100-Ton-Robot/ble-beacon-tracker/rf_model/out/h50327_c65_s15/summary.txt

command: python3 sector_model.py --antenna dipole --centre 65 --spacing 15 --out out/h50327_c65_s15
date: 2026-11-13 03:23 UTC
antenna: dipole, element 58.4 mm, 15 mm in front of the face, feed 65 mm below the deck, other sectors' antennas in, 50 ohm
f0 2440 MHz, mesh [61, 60, 54] cells

match (sector 0 port, 50 ohm):
  2402 MHz  S11   -3.0 dB  Zin   38.2  +87.7j ohm
  2440 MHz  S11   -2.4 dB  Zin   41.7 +104.8j ohm
  2480 MHz  S11   -2.0 dB  Zin   45.9 +123.5j ohm

peak 8.8 dBi at az 0, el 5 deg

elevation   max dBi   at az   -3 dB width   front-to-back (az 0 vs 180)
     0         8.8       0       85 deg       20.5 dB
   -15         7.5       0       85 deg       15.6 dB
   -30         4.1       0      105 deg       17.8 dB
   -45        -1.5       0      145 deg        7.6 dB
   -60        -6.6     290      225 deg       -2.0 dB

isolation, sector 0 -> other sectors' ports (|S21|):
  S1: -50.2 dB
  S2: -50.2 dB
