100-Ton-Robot/ble-beacon-tracker/shield_deck/shield_deck_templates.pdf

## Shield deck drill template - 146 mm disc - PRINT AT 100% (Actual size)

Viewed from the TOP (electronics side). Tape to the board, centre-punch each crosshair, then drill.

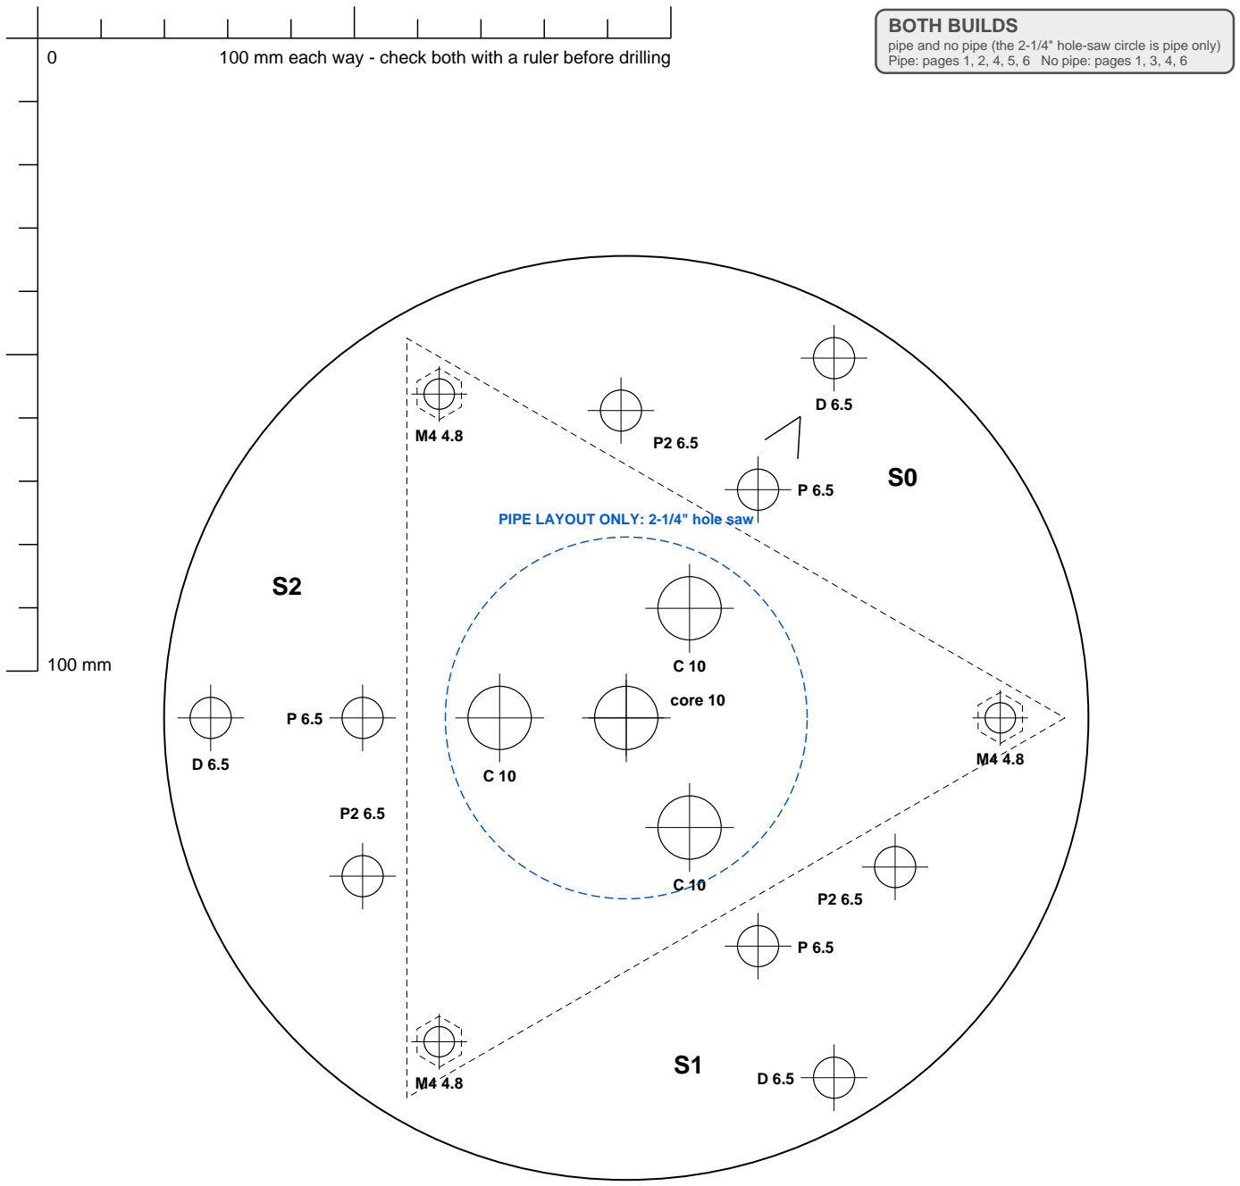
[picture p1: figure]
core 10; PIPE LAYOUT ONLY: 2-1/4" hole saw; BOTH BUILDS

0 | 100 mm each way - check both with a ruler before drilling

Solid circle = cut line (146 mm). Dashed triangle = where the 120 mm back panels stand, copper side out.
D 6.5 mm = rubber duck / monopole / dipole whip (31 mm in front of face) P / P2 6.5 mm = patch (7 mm in front of face; P2 25 mm off centre) C 10 mm = dipole coax pass-through (inside core) M4 4.8 mm = bolts to the plate, nut flush in each core corner
Core 10 mm at the centre = antenna coax into the core; open it up with a hole saw (centre mark) if needed.
Blue dashed 57.1 mm (2-1/4" hole saw) = pipe layout only (page 2): the pipe passes into the core;
it removes the C holes. Other layouts keep the 10 mm core hole. EU: a 57 mm hole saw is the same size.
Arrow points to Sector 0. Holes are symmetric, so the template also works flipped (labels read mirrored). Drawn the same way round as the plates: plate 12 o'clock up, S0 arrow 30 deg clockwise of it.

pipe and no pipe (the 2-1/4" hole-saw circle is pipe only) Pipe: pages 1, 2, 4, 5, 6 No pipe: pages 1, 3, 4, 6

## PIPE electronics plate - 152 mm disc - PRINT AT 100% (Actual size)

Viewed from the TOP. XIAOs, mounts + bus hang UNDER the plate (dashed); PoE splitter + ESP32 inside the core. This layout is only a suggestion. Lay out your own parts and check every hole before drilling.

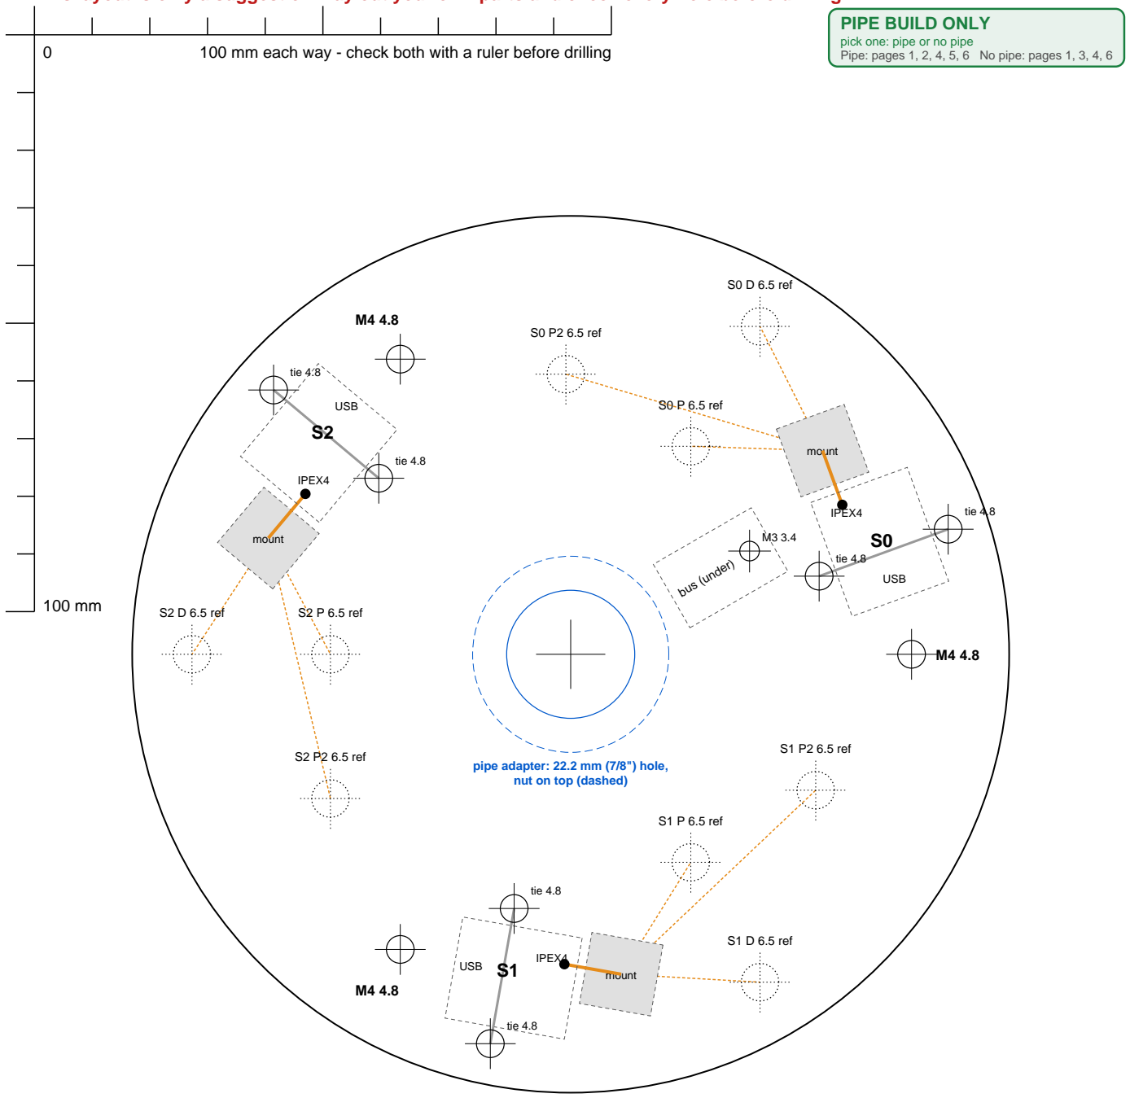
[picture p2: figure]
pipe adapter: 22.2 mm (7/8") hole, nut on top (dashed); mount; USB; IPEX4; bus (under); S0 D 6.5 ref; S0 P 6.5 ref; S0 P2 6.5 ref; S1 D 6.5 ref; S1 P 6.5 ref; S1 P2 6.5 ref; S2 D 6.5 ref; S2 P 6.5 ref; S2 P2 6.5 ref; tie 4.8; PIPE BUILD ONLY pick one: pipe or no pipe

0 | 100 mm each way - check both with a ruler before drilling

Hanging from the ceiling, top down: nut, enclosure top, this module plate, modules + wiring under it, deck, core.
Drill: 3 x 4.8 mm (M4) bolts to the deck, on the deck's M4 holes; 3.4 mm (M3) bus board;
tie hole pairs 4.8 mm (3.0-4.8 fits a 2.5 mm tie), one per XIAO. No pigtail or feed holes: the parts hang under the plate. Antenna holes (dotted, 9 x 6.5 mm): the deck's D / P / P2 jacks, shown for reference only. Not by design; drill if you like. Centre (blue): 22.2 mm (7/8") hole for the 1/2" male adapter's thread, which also goes through the
enclosure top; the nut on top (dashed, size est.) clamps both. Ethernet comes down the pipe (page 5).
EU: a 20 mm x 1/2" BSP male adaptor (R 1/2, 21 mm thread) fits the same 22 mm hole, held by a 1/2" BSP backnut. Each XIAO (under the plate, component side down, beside its own sector): IPEX4 dot -> orange flat coax run ->
1/2" HS-100 tie mount (grey), which clamps it, then (dashed orange) down to whichever of its sector's D / P / P2
jacks is in use, straight below its hole. 5V, GND, D7 to the bus beside them; D6 through the deck's centre hole to
its ESP32 RX pin, beside TX, GND, VBUS coming up. Seen from the top the IPEX4 is on the left (the board is flipped). OPTIONS (builder's choice): this pipe plate or the no-pipe split plate (page 3); bus board under the plate by the adapter, or on the pipe inside the core (page 5: then skip the bus M3).

Pipe: pages 1, 2, 4, 5, 6 No pipe: pages 1, 3, 4, 6

## NO-PIPE electronics plate (split) - 152 mm disc - PRINT AT 100% (Actual size)

Viewed from the TOP. Radios, tie mounts, ESP32 + bus all hang UNDER the plate (dashed, seen through it).
This layout is only a suggestion. Lay out your own parts and check every hole before drilling.

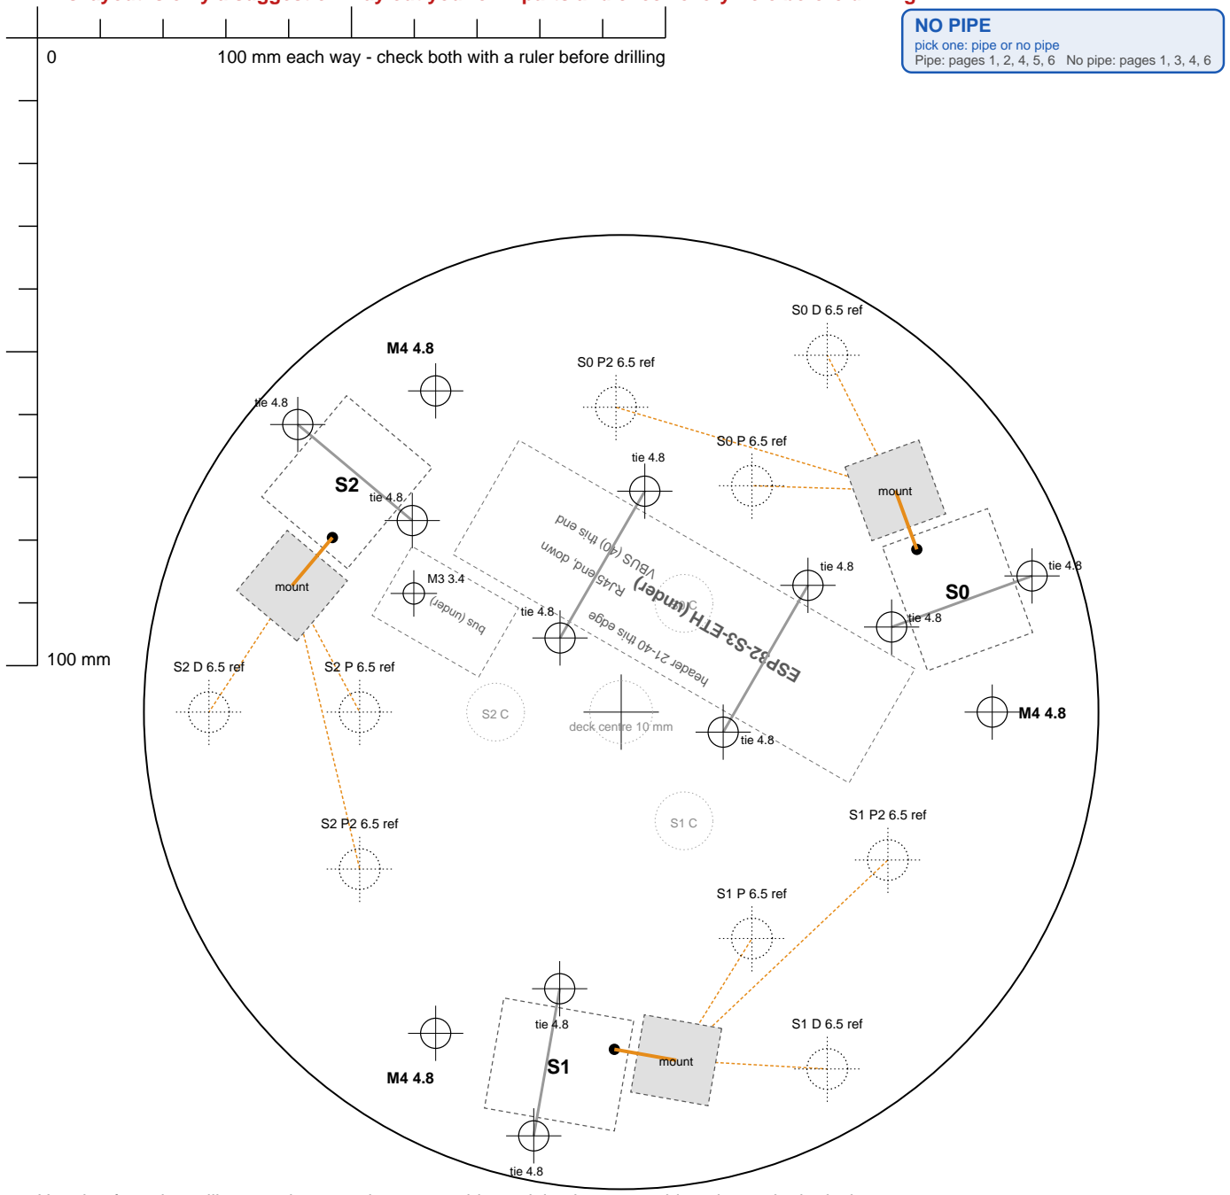
[picture p3: figure]
deck centre 10 mm; mount; S0 D 6.5 ref; S0 P 6.5 ref; S0 P2 6.5 ref; S1 D 6.5 ref; S1 P 6.5 ref; S1 P2 6.5 ref; S2 D 6.5 ref; S2 P 6.5 ref; S2 P2 6.5 ref; tie 4.8; NO PIPE pick one: pipe or no pipe

0 | 100 mm each way - check both with a ruler before drilling

Hanging from the ceiling, top down: enclosure top, this module plate, everything else under it, deck, core.
Drill: 3 x 4.8 mm (M4) bolts to the deck, on the deck's M4 holes; 3.4 mm (M3) bus board. No harness holes.
Tie hole pairs 4.8 mm (any 3.0-4.8 mm fits a 2.5 mm tie): one across each XIAO, two across the ESP32.
Antenna holes (dotted, 9 x 6.5 mm): the deck's D / P / P2 jacks, shown for reference only. Not by design; drill if you like. XIAOs (in the gaps between the sectors' holes) on VHB + a zip tie (grey bar), IPEX4 dot -> orange coax -> 1/2" HS-100
tie mount, which clamps it, then on (dashed orange) to its own sector's D / P / P2 jack in use: one smooth sweep, bending
down through the spacer gap. Nothing sits within 8 mm of an antenna hole (the coax rises straight from its jack).
ESP32: across the middle, RJ45 / USB-C end toward 10 o'clock, hung RJ45 side down; USB-C then faces the plate: standoffs or a slim right-angle plug. A 90 deg adapter turns the RJ45 sideways; patch + USB-C lead to the PoE splitter's 4" box.
Bus by the ESP32's RJ45 end (VBUS 40). Spacers 25-30 mm. Clearances are tight (~2-3 mm): check with the real parts. Positions: parameters.csv (lay out in plate_layout.svg). The ESP32 only clears the deck's 10 mm centre hole: no hole saw. OPTIONS (builder's choice): this no-pipe split plate or the pipe plate (page 2). Wiring: page 6.

Pipe: pages 1, 2, 4, 5, 6 No pipe: pages 1, 3, 4, 6

## Back panel (reflector face) template - 120 x 120 mm - PRINT AT 100%

Make 3. Viewed from the FRONT (copper side, facing the antenna). Top edge goes against the shield deck.

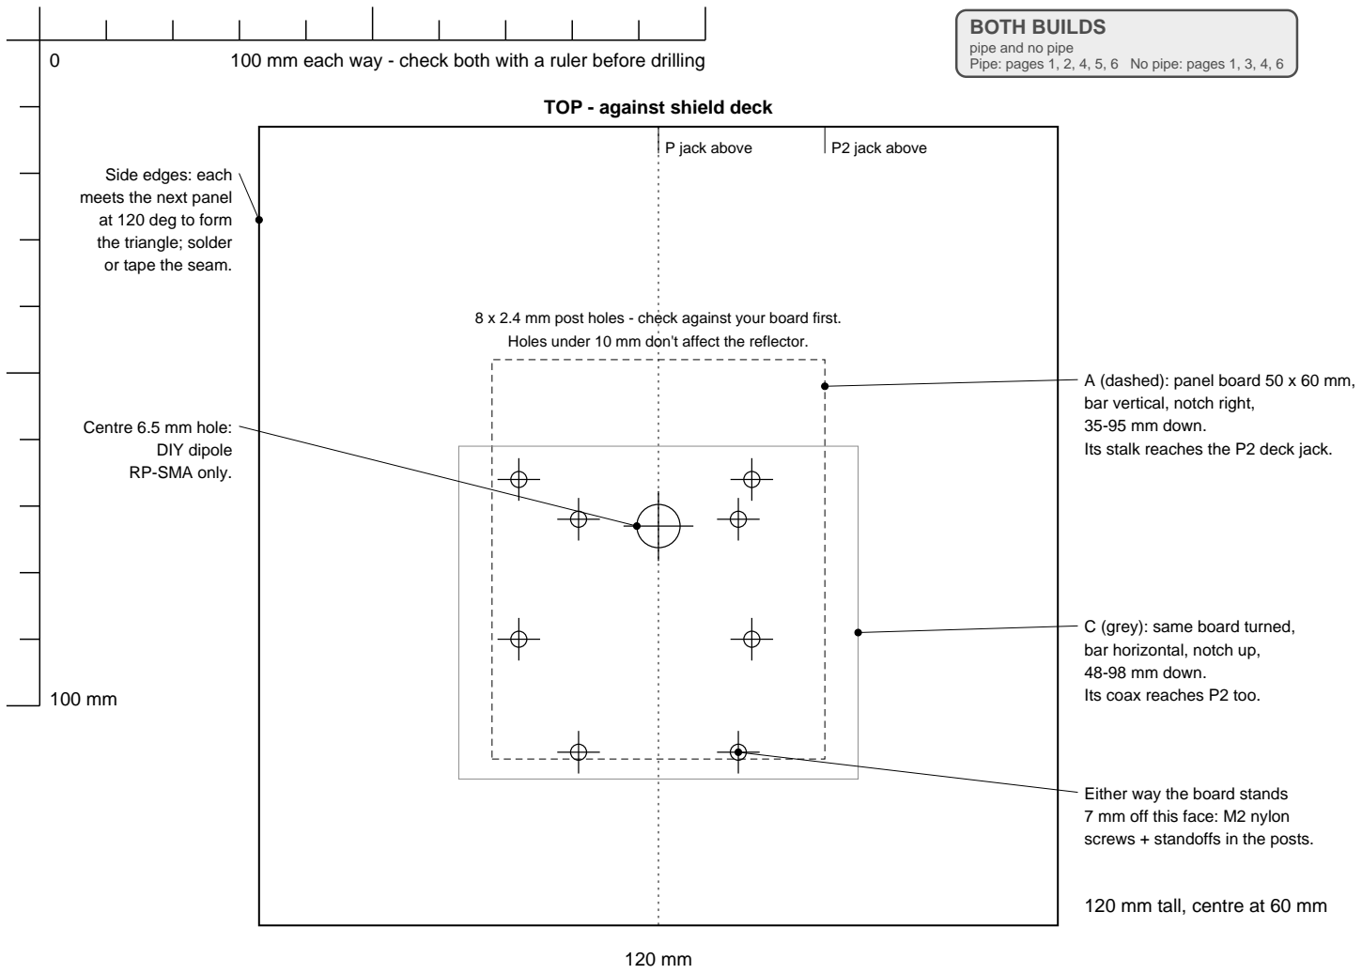
[picture p4: figure]
TOP - against shield deck; P jack above; P2 jack above; A (dashed): panel board 50 x 60 mm, bar vertical, notch right, 35-95 mm down. Its stalk reaches the P2 deck jack.; C (grey): same board turned, bar horizontal, notch up, 48-98 mm down. Its coax reaches P2 too.; Either way the board stands 7 mm off this face: M2 nylon screws + standoffs in the posts.; Centre 6.5 mm hole: DIY dipole RP-SMA only.; Side edges: each meets the next panel at 120 deg to form the triangle; solder or tape the seam.; 120 mm tall, centre at 60 mm; BOTH BUILDS pipe and no pipe

0 | 100 mm each way - check both with a ruler before drilling

8 x 2.4 mm post holes - check against your board first. Holes under 10 mm don't affect the reflector.

Whips (rubber duck / monopole / dipole) don't mount on this face: they hang on the deck's D holes, 31 mm in front of it (page 1).

Pipe: pages 1, 2, 4, 5, 6 No pipe: pages 1, 3, 4, 6

## Pipe stack - top and side views - scale 0.6 (NOT a drilling template)

Hanging from the ceiling, top down: nut, enclosure top, module plate, modules, deck, core, ESP antenna. Frame: page 2.

TOP: inside the core, looking down

ESP32

PoE

bus (option)

S0 face

S1 face

S2 face

11 o'clock corner:
cables (+ bus option)

dotted: adapter hex (above the deck) and the 2-1/4" deck hole;
dotted hexes: M4 nuts under the deck

SIDE: cut through 3 - 9 o'clock

enclosure top
module plate

S2 XIAO (under the plate)

deck

nut

1/2" male adapter
M4 + spacer
S2 face | corner

copper end plate (optional): bond all 3 edges or leave it off 1/2" cap, drilled and tapped for the RP-SMA

pigtail in via notch

1/2" PVC

ESP antenna (RP-SMA in the cap)

RJ45

ESP32

bus
(option)

PoE

Ethernet (PoE) from the ceiling, down the pipe

side slot

Pipe: 1/2" PVC (21.3 mm OD) from the male adapter's socket through the 2-1/4" deck hole, ~137 mm long (check the socket depth), capped flush with the core's far end. The cap is drilled and tapped: the ESP antenna's RP-SMA bulkhead threads into it, and the U.FL pigtail from the ESP32 enters through a notch in the cap rim. The antenna, screwed onto the bulkhead, clamps the copper end plate that closes the core (optional; see END PLATE, left).
Splitter and ESP32 zip-tied to the pipe facing the 3 and 7 o'clock corners (widest room), RJ45 / USB-C end up;
the 11 o'clock corner is left for cables (and the bus option). Ethernet (PoE, green): from the ceiling down the adapter's bore and the pipe, out a side slot (about 12 x 16 mm, cut before gluing) beside the splitter. An RJ45 plug (11.7 mm wide) fits the ~16 mm bore: pull it through before fitting any boot, or crimp after. The adapter's thread goes up through the module plate and the enclosure top; the nut on top clamps both. Modules and the bus hang under the plate (page 2). OPTION: the bus board can go on the pipe (dashed, 11 o'clock, opposite the ESP32 and splitter) instead of on the plate. Side: dashed box = PoE splitter, behind the cut. XIAOs, tie mounts: as page 2. Estimates: adapter, nut,
enclosure top, splitter size, board depths, antenna length.
EU parts: 20 mm PVC-U pressure pipe (20 mm OD, 1.3 mm under 1/2" Sch 40; same holes), a 20 mm solvent-weld end cap, a 20 mm x 1/2" BSP male adaptor and a 1/2" BSP backnut, and a 57 mm hole saw for the deck. The RP-SMA bulkhead's thread is 1/4"-36 UNS everywhere: if that tap is hard to find, drill the cap 6.5 mm and use the bulkhead's own nut.

OPTION: 1/2" EMT (steel conduit) instead of the PVC EMT: 17.9 mm OD, 15.8 mm bore (PVC: 21.3 / 15.8 mm). Set-screw or compression connector + locknut in the same 7/8" (22.2 mm) hole; the deck hole stays.
RJ45: a crimped head only just fits the 15.8 mm bore (check the connector's throat too). Make sure there is NO boot or crimp sleeve on the plug going through. Bond the tube to the deck all round where it passes: copper collar, ground clamp + braid, or conductive copper tape (solder won't take on galvanized steel). ESP antenna: plastic cap or bushing, not bare steel. Bushing on every cut or drilled hole a cable passes near or through (side slot, tube ends), even deburred. Outdoors: seal the zinc-copper bond (corrosion). The drawing shows the PVC pipe.

END PLATE: leave it off, or bond it all round - never held by the antenna screw alone.
Worst: plate on the antenna screw only. Its loose edges make slots (a face is 120 mm; ~62 mm resonates at 2.4 GHz) that re-radiate and can detune the antennas. Fine: no plate. The faces still shield the sides; the
open end leaks ESP32 / splitter noise downward. Best: plate bonded along all 3 edges, gaps < ~25 mm (copper tape over the seams, or spring tabs / screws every 20-25 mm), star washer under the antenna nut. No plate: use a self-contained antenna on the cap
(a sleeve-dipole rubber duck), not a bare 1/4-wave whip. Build without it first; add a bonded plate only if the
XIAOs see noise with the ESP32 and splitter running.

50 mm at drawing scale

PIPE BUILD ONLY
pick one: pipe or no pipe
Pipe: pages 1, 2, 4, 5, 6 No pipe: pages 1, 3, 4, 6

## Wiring diagram - XIAO radios, JST pairs, bus board, ESP32

Not to scale for mounting: shows connections only. Pin numbers in brackets. Pad positions approximate. JST halves drawn apart: XIAO half beside the radio, far half by the bus; same name = they plug together.

ESP32-S3-ETH

RJ45 + USB-C end

TX / GND / 5V bus

TX row (1st)

GND row (2nd)

5V row (4th)

### S0 XIAO

USB-C

IPEX4

from S1 XIAO,
wired as S0

from S2 XIAO,
wired as S0

JST S0

far half

1

2

3

4

JST S0

XIAO half

1

2

3

4

JST S1

far half

1

2

3

4

JST S1

XIAO half

1

2

3

4

JST S2

far half

1

2

3

4

JST S2

XIAO half

1

2

3

4

ESP | S0 | S1 | S2

VBUS (40) -- bus 5V row

GND (38) -- bus GND row

GPIO21 TX (35) -- bus TX row

D6 TX (7) -- JST 3 -- ESP32 GPIO17 RX (34)

GPIO17 RX (34) -- S0 XIAO D6 TX (7)

D7 RX (8) -- JST 4 -- bus TX row, col S0 GND (13) -- JST 2 -- bus GND row, col S0 5V (14) -- JST 1 -- bus 5V row, col S0

GPIO16 RX (32) -- S1 XIAO D6 TX (7)

GPIO18 RX (31) -- S2 XIAO D6 TX (7)

All three XIAOs are wired the same, pad for pad, to their own JST:
5V (14) -> 1, GND (13) -> 2,
D6 TX (7) -> 3, D7 RX (8) -> 4.

Shared by every radio on the bus: 5V, GND and the ESP32 TX (GPIO21) into every D7. All radios hear the same commands; each names one chip ID (or all), and only the named radios act.

Only D6 TX differs: each radio talks back on its own ESP32 RX pin, and that pin is the sector. More radios =
one more JST pair, bus column and ESP RX each. The ESP32-S3's 3 hardware UARTs are all used: a 4th radio needs another UART or a second gateway.

D6 -> its own ESP RX (the pin is the sector): S0 GPIO17 (34), S1 GPIO16 (32), S2 GPIO18 (31).
ESP TX GPIO21 (35) -> bus TX row -> every D7. Feed: TX (35) -> TX row, VBUS (40) -> 5V row, GND (38) -> GND row. Bus: hole end up, rows bridged, 3rd row spare. ESP32 as drawn (RJ45 side up): VBUS (40) is the top right header pin. JST head (either half), crimp side, key peg up:

key peg

1

red
5V
XIAO 14

2

black
GND
XIAO 13

3

yellow
D6 TX
XIAO 7

4

green
D7 RX
XIAO 8

Pins left to right: 1 red 5V, 2 black GND, 3 yellow D6 TX, 4 green D7 RX.
Male and female halves carry the same colours in the same order on the crimp side, so the XIAO tail and the far tail match colour for colour through the joint.
XIAO tail: red -> 5V (14), black -> GND (13), yellow -> D6 (7), green -> D7 (8).
Far tail: red -> bus 5V row, black -> bus GND row, green -> bus TX row, yellow -> that sector's ESP RX pin (labels on the drawing). Female half on the far tail keeps 5V covered.

BOTH BUILDS
pipe and no pipe
Pipe: pages 1, 2, 4, 5, 6 No pipe: pages 1, 3, 4, 6

## Design formulas - monopoles, triangle, baseplate (NOT a template, not to size)

Worked from parameters.csv: change a value there and re-run make_templates.py, and every number here follows.

TOP VIEW: baseplate (shield deck) + triangle core, S0 up, scale 0.7

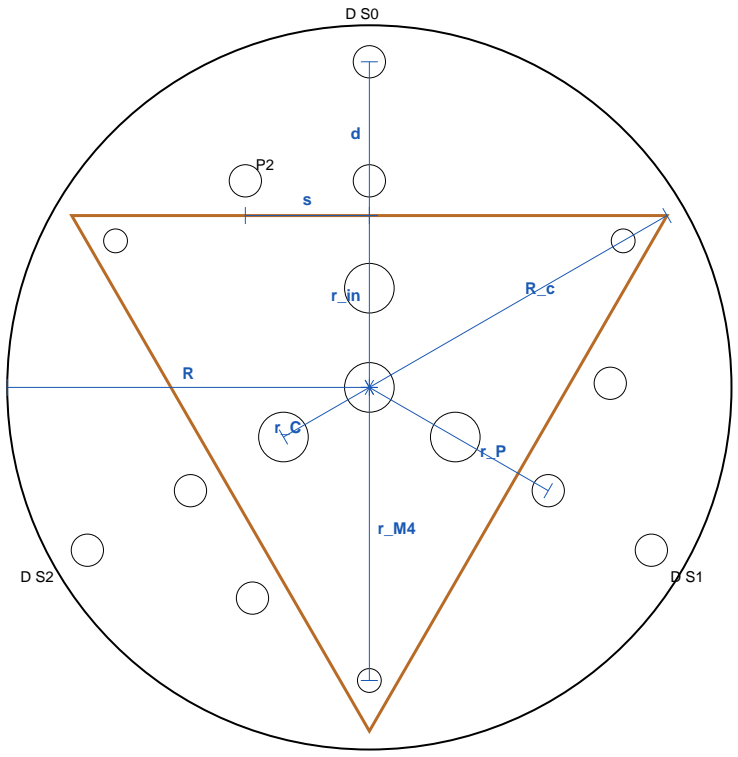
[picture p5: figure]

Copper line = the triangle's outer (copper) faces. Circles = deck holes. Blue = the dimensions below.

TRIANGLE CORE (3 back panels)
a = FACE_WIDTH (side of the triangle) | 120 mm
r_in = a / (2 x sqrt 3) | 34.64 mm
centre -> face (inradius)
R_c = a / sqrt 3 = 2 x r_in | 69.28 mm
centre -> corner (circumradius)
height of the triangle = a x sqrt 3 / 2 = 3 x r_in | 103.9 mm
back panel = a x h (h = FACE_H), make 3 | 120 x 120 mm
panels meet at 60 deg inside / 120 deg between faces
inner face = r_in - t (t = FACE_THICK) | 33.04 mm
corner clearance = R - R_c | 3.7 mm
must stay > 0: the corners sit inside the deck rim
a / lambda (reflector width per sector) | 0.98
about one wavelength wide
BASEPLATE (shield deck)
R = DISC_DIAMETER / 2 | 73 mm
D hole: r_D = r_in + d at 0 / 120 / 240 deg | 65.64 mm
D rim margin = R - r_D - HOLE_RPSMA / 2 | 4.1 mm
P hole: r_P = r_in + p (p = PATCH_OFFSET) | 41.64 mm
P2: s = a / 2 - PATCH_END_INSET (along the face) | 25 mm
P2: r = sqrt(r_P^2 + s^2), turned atan(s / r_P) CCW | 48.57 mm, 31.0 deg
C hole: r_C = COAX_PASS_RADIUS (inside the core) | 20 mm
M4: r_M4 = 2 x (r_in - t - NUT_AF / 2 - NUT_GAP) | 59.08 mm
at the corners (60 / 180 / 300 deg): a hex nut in a 60 deg corner sits
twice its flat-to-face distance from the corner, two flats on the faces
stitch vias: STITCH_COUNT on STITCH_RADIUS | 36 on 71 mm

SIDE VIEW: cut through the S0 axis, deck on top, scale 0.56

RP-SMA

inside the core
(S1 / S2 faces meet at the back)

d

L

h

R_c + r_in

Whip drawn as a bare quarter-wave monopole; the deck is its ground plane, the face its reflector.

MONOPOLES (D holes)
f = RF_FREQ (BLE band centre) | 2440 MHz
lambda = c / f | 122.9 mm
d = lambda / 4 (whip -> copper face) | 30.7 mm
DUCK_SPACING = 31 mm (d / lambda = 0.252)
why: out and back 2d = lambda / 2 (180) + copper flip (180) 360 deg
the reflected wave comes back in phase and adds to the forward wave
L = lambda / 4 (bare monopole over the deck) | 30.7 mm
rubber duck: lambda / 2 sleeve dipole element | ~61 mm
backed length = h = FACE_H below the deck | 120 mm
a whip longer than h hangs past the copper and loses some backing
D hole to the far corner = R_c + r_in + d | 134.9 mm

Units: mm and degrees, clockwise from S0 (top view) unless marked CCW. Names in capitals are parameters.csv rows.

REFERENCE
both builds; no need to print
Pipe: pages 1, 2, 4, 5, 6 No pipe: pages 1, 3, 4, 6
