100-Ton-Robot/ble-beacon-tracker/rf_model/out/bearing_spacing/summary.txt

command: python3 bearing_sim.py out/h50327_c65_s15 out/h50327_c65_s20 out/h50327_c65_s25 out/h50327_c65 out/h50327_c65_s34 --out out/bearing_spacing
date: 2026-11-13 03:24 UTC
fading 5.0 dB/advert, 3 adverts/s, room 3.0 dB, shadow 4.0 dB, window 1 s, mast 1.4 m above the beacon, beacons 1-15 m out, n 2.2

pattern      |bearing error| deg: median  90%   rms   (<=5 m / >5 m median)   right sector   range error: median  90%
h50327_c65_s15                        19    60    40      ( 21 /  16)              81.4%               44%  107%
h50327_c65_s20                        19    60    41      ( 22 /  16)              80.8%               44%  109%
h50327_c65_s25                        19    62    42      ( 23 /  16)              79.3%               45%  107%
h50327_c65                          20    63    42      ( 23 /  17)              77.8%               44%  107%
h50327_c65_s34                        21    64    42      ( 24 /  17)              77.3%               44%  108%

median |bearing error| deg, room reflections x tracker window (fading, adverts, shadow as above):
  room dB  window s  h50327_c65_s15  h50327_c65_s20  h50327_c65_s25  h50327_c65  h50327_c65_s34
        0         1          14          15          15          16          16
        0         5           7           7           7           7           7
        2         1          17          17          17          18          19
        2         5          11          11          12          12          12
        3         1          20          20          20          21          22
        3         5          15          16          16          17          17
        5         1          26          26          27          28          29
        5         5          24          25          25          26          26
