100-Ton-Robot/ble-beacon-tracker/rf_model/out/dipole_len50/summary.txt

command: python3 sector_model.py --antenna dipole --length 50 --out out/dipole_len50
date: 2026-11-13 03:12 UTC
antenna: dipole, element 50.0 mm, feed 45 mm below the deck, other sectors' antennas in, 50 ohm
f0 2440 MHz, mesh [59, 61, 55] cells

match (sector 0 port, 50 ohm):
  2402 MHz  S11   -7.8 dB  Zin   68.9  -48.9j ohm
  2440 MHz  S11   -9.3 dB  Zin   72.7  -37.7j ohm
  2480 MHz  S11  -10.8 dB  Zin   76.8  -26.0j ohm

peak 7.5 dBi at az 0, el 0 deg

elevation   max dBi   at az   -3 dB width   front-to-back (az 0 vs 180)
     0         7.5       0      105 deg       22.0 dB
   -15         6.5       0      115 deg       14.9 dB
   -30         3.9       0      125 deg       17.3 dB
   -45        -0.5     350      155 deg        8.6 dB
   -60        -5.5     180      115 deg       -1.0 dB

isolation, sector 0 -> other sectors' ports (|S21|):
  S1: -48.6 dB
  S2: -48.6 dB
