100-Ton-Robot/ble-beacon-tracker/rf_model/out/h50327_c55/summary.txt

command: python3 sector_model.py --antenna dipole --centre 55 --out out/h50327_c55
date: 2026-11-13 03:13 UTC
antenna: dipole, element 58.4 mm, feed 55 mm below the deck, other sectors' antennas in, 50 ohm
f0 2440 MHz, mesh [59, 61, 54] cells

match (sector 0 port, 50 ohm):
  2402 MHz  S11   -5.4 dB  Zin  107.8  +74.4j ohm
  2440 MHz  S11   -4.6 dB  Zin  115.7  +88.1j ohm
  2480 MHz  S11   -4.1 dB  Zin  124.3 +102.3j ohm

peak 7.9 dBi at az 0, el 5 deg

elevation   max dBi   at az   -3 dB width   front-to-back (az 0 vs 180)
     0         7.9       0       95 deg       20.1 dB
   -15         6.6       0      105 deg       14.1 dB
   -30         3.3       0      125 deg       15.0 dB
   -45        -2.5     335      175 deg        5.4 dB
   -60        -5.2     180       85 deg      -16.1 dB

isolation, sector 0 -> other sectors' ports (|S21|):
  S1: -47.3 dB
  S2: -47.3 dB
