100-Ton-Robot/ble-beacon-tracker/rf_model/out/h50327_c65/summary.txt

command: python3 sector_model.py --antenna dipole --centre 65 --out out/h50327_c65
date: 2026-11-13 03:13 UTC
antenna: dipole, element 58.4 mm, feed 65 mm below the deck, other sectors' antennas in, 50 ohm
f0 2440 MHz, mesh [59, 61, 54] cells

match (sector 0 port, 50 ohm):
  2402 MHz  S11   -5.0 dB  Zin  107.2  +81.8j ohm
  2440 MHz  S11   -4.3 dB  Zin  115.7  +95.9j ohm
  2480 MHz  S11   -3.8 dB  Zin  125.2 +110.6j ohm

peak 8.0 dBi at az 0, el 5 deg

elevation   max dBi   at az   -3 dB width   front-to-back (az 0 vs 180)
     0         7.9       0       95 deg       19.0 dB
   -15         6.5       0      105 deg       14.0 dB
   -30         3.4       0      125 deg       15.0 dB
   -45        -1.2       0      165 deg        6.7 dB
   -60        -5.7     180       95 deg       -0.5 dB

isolation, sector 0 -> other sectors' ports (|S21|):
  S1: -44.7 dB
  S2: -44.7 dB
