100-Ton-Robot/ble-beacon-tracker/rf_model/out/h50327_c75/summary.txt

command: python3 sector_model.py --antenna dipole --centre 75 --out out/h50327_c75
date: 2026-11-13 03:14 UTC
antenna: dipole, element 58.4 mm, feed 75 mm below the deck, other sectors' antennas in, 50 ohm
f0 2440 MHz, mesh [59, 61, 54] cells

match (sector 0 port, 50 ohm):
  2402 MHz  S11   -4.7 dB  Zin  108.8  +87.1j ohm
  2440 MHz  S11   -4.1 dB  Zin  117.9 +101.3j ohm
  2480 MHz  S11   -3.6 dB  Zin  128.2 +115.9j ohm

peak 7.8 dBi at az 0, el 5 deg

elevation   max dBi   at az   -3 dB width   front-to-back (az 0 vs 180)
     0         7.7       0       95 deg       18.5 dB
   -15         6.3       0      105 deg       14.8 dB
   -30         3.8       0      115 deg       17.3 dB
   -45         1.1       0      135 deg        9.6 dB
   -60        -1.7       0      165 deg        5.5 dB

isolation, sector 0 -> other sectors' ports (|S21|):
  S1: -42.6 dB
  S2: -42.6 dB
