100-Ton-Robot/ble-beacon-tracker/rf_model/out/bearing/estimate_vs_true.png

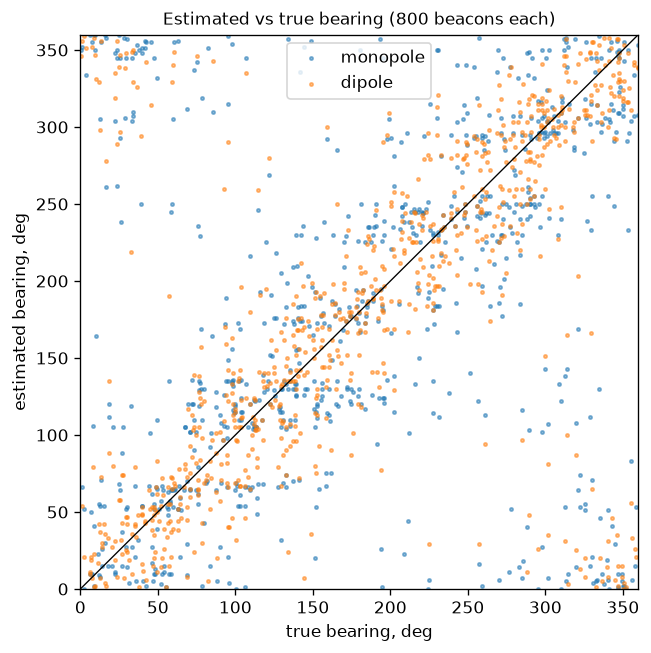
rf_model/out/bearing/estimate_vs_true.png
