100-Ton-Robot/ble-beacon-tracker/rf_model/out/bearing_h50327/estimate_vs_true.png

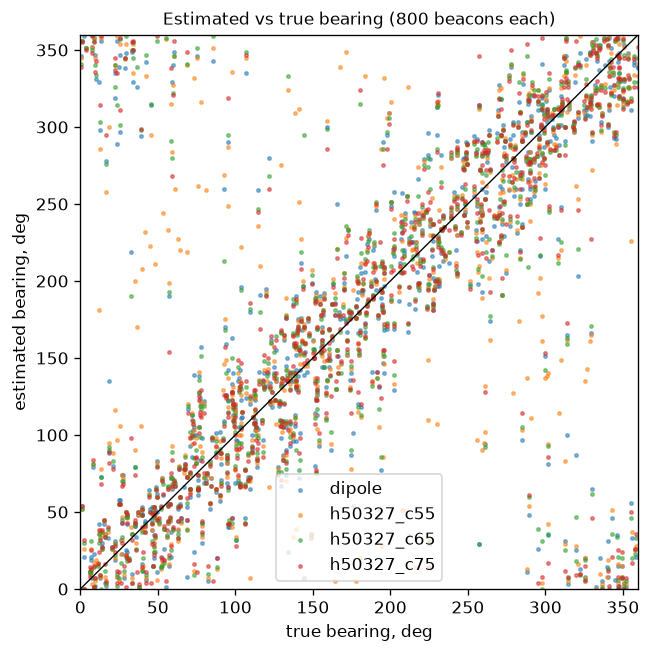
rf_model/out/bearing_h50327/estimate_vs_true.png
