100-Ton-Robot/ble-beacon-tracker/rf_model/out/bearing_spacing/error_vs_bearing.png

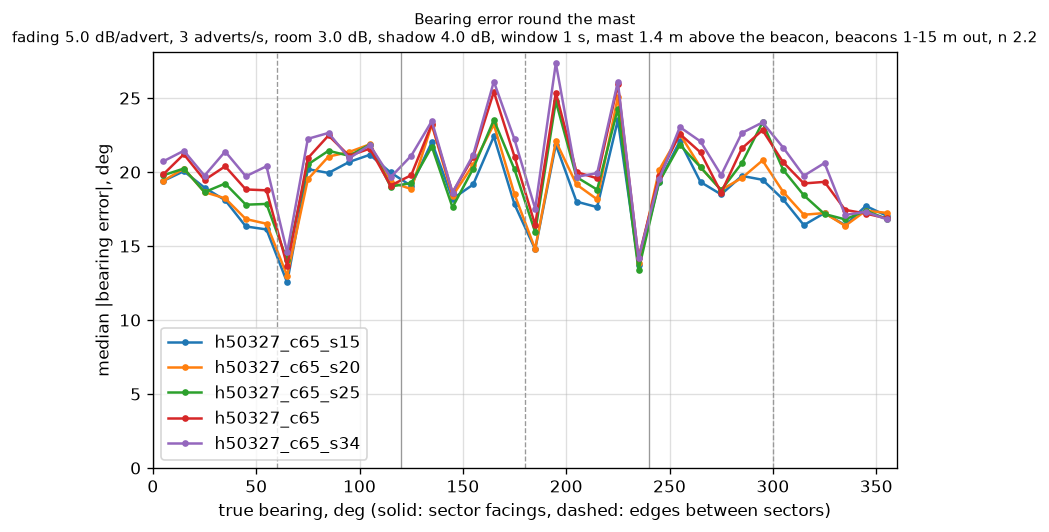
rf_model/out/bearing_spacing/error_vs_bearing.png
