100-Ton-Robot/ble-beacon-tracker/rf_model/out/bearing_spacing/estimate_vs_true.png

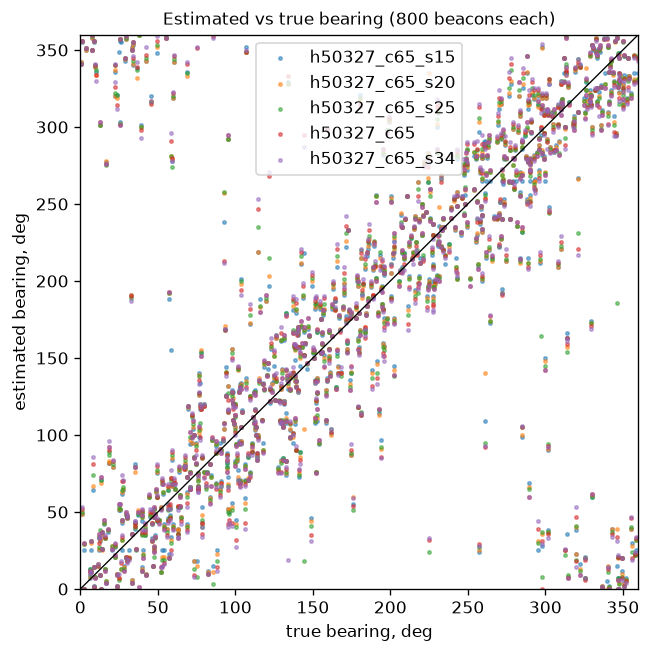
rf_model/out/bearing_spacing/estimate_vs_true.png
