100-Ton-Robot/ble-beacon-tracker/rf_model/out/h50327_c65_s15/pattern.png

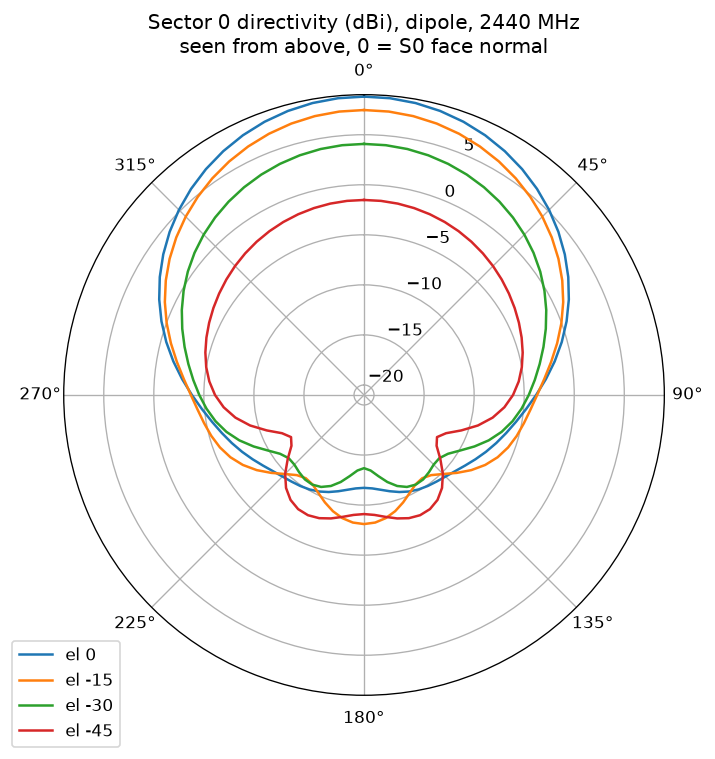
rf_model/out/h50327_c65_s15/pattern.png
