100-Ton-Robot/ble-beacon-tracker/(commit log)

2026-10-31 BLE beacon tracker: scanner firmware v0.3.0, gateway, shield deck
    Scanner firmware (XIAO nRF54L15, nRF Connect SDK, MCUboot) with release
    DFU images, the ESPHome gateway and its sector_scanner component, the
    shield deck PCB and template scripts, and the KiCad deck experiment.
    MIT licensed.
    [hole_table.csv, shield_deck.kicad_pcb]
2026-10-31 gateway: frame/command v2 for scanner fw 0.3.0; API for HA, MQTT for data only
    - Reads only frame v2 (16-byte header with chip_id); v1 frames count as bad.
    - Learns each RX pin's chip ID ("chip" in the JSON, chip text sensor) and sets
    the scanner's sector to its pin's (cmd 4, addressed, at most every 5 s).
    - One shared command TX (GPIO21) to every D7; addressed v2 commands from MQTT
    bletracker/<mast>/<sector>/cmd and bletracker/<mast>/all/cmd (listen, flash,
    ant, reboot), plus flash-mode and reboot buttons per sector.
    - JSON adds scanner_sector, listening, flash, client, test_image.
    - Pins: RX GPIO17/16/18 (header 34/32/31), TX GPIO21 (35); GPIO1/2 freed.
    - Home Assistant entities over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
2026-10-31 gateway: example per-mast YAML + shared package
    bletracker-gateway.yaml moves to packages/ (shared by every mast, not a device
    config on its own; the dashboard would list a top-level file as a device).
    example-mast.yaml is the per-mast file: mast ID, name, API key secret, packages:
    include, DHCP with a commented static IP block. README and secrets.example
    updated. Both the DHCP and the static variant validate; example-mast.yaml
    compiles clean on ESPHome 2026.9.0.
2026-10-31 docs: align READMEs with gateway v2, drop machine-specific notes
    - README: gateway status (v2, runs on a board, no scanner frames yet),
    gateway row covers package/example-mast and commands, link experiments.
    - scanner_fw/README: flash mode via the gateway's HA button or MQTT;
    signing key path comes from sysbuild.conf; state the SDK/app paths the
    commands assume; generic wording for Chocolatey, smpmgr adapter and test
    beacon; swap-test example signs the current version (0.3.0).
    - experiments/kicad_deck: out/ is ignored, regenerate with build.py; drop
    reference to an external plan doc.
    - .gitignore comments: no script that isn't in the repo.
    - CLAUDE.md: gateway layout (packages/, ex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
2026-10-31 docs: swap-test slot values checked against the devicetree partitions
    Claude-Session: https://claude.ai/code/session_01F9rAFs4sbwhvVeAxVarGjJ
2026-11-02 scanner_fw 0.3.1: bench test of primary channel scanning
    Add a `chan auto|37|38|39|rot [s]` console command that limits scanning to
    one primary advertising channel or rotates 37-39 at the 1 s boundary, via the
    SoftDevice vendor scan channel map. The map only applies when scanning starts,
    so each change stops and restarts the scan; the [1s] line now shows the channel
    and the restart time. Not saved; every boot is `auto`. Groundwork for the
    frame v3 lockstep channel plan.
    tools/chan_test.py compares the modes over the USB console, as rates or
    (--by-address) per address. On one XIAO: no advert loss on a single channel or
    1 Hz rotation, about 2.7 ms per switch, and up to 23 dB RSSI difference
    b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
2026-11-02 scanner_fw tools: slot_sim.py for the frame v3 slot count
    Captures raw adverts from one scanner's console on a fixed channel and
    rebuilds each 1 s window per address with N time slots (mean time, mean
    RSSI, count), reporting entries and bytes per second, merged share, time
    smear, per-second median error and within-second spread kept. A 2 min bench
    capture showed 10 slots keep the median within 0.04 dB and 93% of the spread.
    [slot_sim.py]
2026-11-02 scanner_fw tools: multi_compare.py, README note on USB hubs
    multi_compare.py records several scanners side by side over their USB
    consoles (one thread per board, optional `chan` per board) and reports
    per-board unique addresses and rates, addresses heard by all or one, board
    offsets, and a per-address RSSI table.
    README: a XIAO plugged straight into a USB hub lost everything weaker than
    about -70 dBm (5 addresses vs 22 on a cable, same board and channel), and
    `adapter serial` picks which board OpenOCD flashes when several are attached.
2026-11-02 shield_deck templates: IPEX4 single pigtail hole, page order, alt split plate
    - Plate: one 10 mm pigtail hole level with S1's IPEX4, JST pairs moved,
    ESP32 ties clear of them; IPEX4 / MHF4 labels and strain-relief notes.
    - Page order: deck, plate, wiring, alt plate, back panel; deck drawn the
    same way round as the plate.
    - New page 4: alternative split plate with the XIAOs on the underside
    (VHB + one zip tie each, adhesive tie mount clamping each coax), ESP32
    and bus board on top, harness holes, no pigtail hole.
2026-11-02 scanner_fw 0.4.0: protocol 3 (protobuf buckets every 200 ms)
    Replaces frame/command v2 with protobuf (nanopb) inside the existing
    COBS + CRC-16 framing. Every 200 ms tick sends one Bucket: RSSI per
    address, optional raw advert / scan response payloads, status,
    counters and categorised events (security events included). Commands
    are protobuf too, acknowledged by events. A byte budget and throttle
    shed payloads before RSSI. The sector is now a claim set at assembly;
    the gateway validates it instead of setting it.
    Spec in scanner_fw/PROTOCOL.md, schema in scanner_fw/proto/.
    decode_frames.py decodes buckets and builds commands. The gateway
    component still reads v2 and is marked out of step.
    Co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
    [decode_frames.py, main.c]
2026-11-04 gateway: scanner protocol 3 and MQTT layout v3
    Reads protobuf buckets (hand-written wire reader), checks each
    scanner's sector claim against its RX pin instead of setting it, and
    publishes layout v3 in place of the one JSON message per sector:
    batched rssi, Theengs-style adv, status, counters, events, security,
    raw and retained change-only scanner state, plus mast online (LWT),
    retained info and gateway commands reboot|clear. Retained topics are
    cleared at every MQTT connect. SNTP clock (ntp_server substitution).
    Protobuf commands with ack tracking, settings kept applied from the
    scanners' status, budget throttle, boot self-test with data from
    tools/make_selftest.py (passes on a board: comma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
2026-11-05 docs: all three scanners on firmware 0.4.0
    README status now covers scanner firmware 0.4.0 and the protocol 3
    gateway. CHANGELOG gains the missing 0.3.1 and 0.4.0 entries, including
    why a board can show "not set" after updating from 0.3.x. The scanner
    README adds app-only USB updates and picking a board by probe serial.
2026-11-05 shield_deck: M4 nuts in the core corners, core feed hole, alt and flange plates
    Deck: M4 holes move to 59.1 mm radius (4.8 mm) so a nut sits flush in each
    inside core corner on a 9 mm bottom pad, and a 10 mm centre hole feeds
    antenna coax into the core. Templates gain the alt split plate and the
    flange plate with its stack views. make_plate_svg.py writes the Inkscape
    layout, saved beside a proposed hand layout. Docs say "the enclosure".
    [hole_table.csv]
2026-11-09 shield_deck templates: pipe layout, options, notes by their drawings
    The flange gives way to a 1/2" male adapter through the enclosure bottom
    and the pipe plate, clamped by a nut on top; the pipe's cap is tapped for
    the ESP antenna's RP-SMA and notched for its pigtail. The deck page shows
    the pipe layout's 2-1/4" hole saw circle. The original plate template is
    dropped (its wiring page stays as the pin reference). The alt plate's
    ESP32 moves off the deck centre hole to 12 o'clock. The pipe plate's bus
    moves in beside the nut, with a bus-on-pipe option in the 11 o'clock
    corner; both plates and the bus position are marked as builder's options.
    Back panel notes become callouts beside the parts t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
2026-11-09 shield_deck templates: EU plumbing equivalents
    The deck, pipe plate and stack pages note the EU parts: 20 mm PVC-U
    pressure pipe and end cap, a 20 mm x 1/2" BSP male adaptor with a 1/2"
    BSP backnut, and a 57 mm hole saw. The RP-SMA bulkhead thread is
    1/4"-36 UNS everywhere; without that tap, drill 6.5 mm and use its nut.
2026-11-10 shield_deck: P2 moved in, plates re-laid out clear of the antenna holes
    - Deck: P2 jack 25 mm off each face centre (was 14 mm in from the face
    end) so the panel board's coax reaches it from back-panel positions
    A and C without extending. Gerbers, hole table and README regenerated.
    - Back panel: P / P2 jack marks along the top edge.
    - Both module plates follow the hanging stack (modules under the plate),
    drill the deck's D / P / P2 holes through, and keep every part 8 mm
    off the antenna holes. Radios lie along the rim between the sectors;
    each coax runs IPEX4 -> tie mount -> its own sector's jacks.
    - Alt plate: ESP32 across the middle, bus by its RJ45 end; only the
    10 mm centre ho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
    [hole_table.csv]
2026-11-10 shield_deck: all numbers in parameters.csv, plates round-trip through Inkscape
    Every measurement, part size, placement and clearance rule moves out of the
    scripts into parameters.csv (name, value, unit, source, group, note), loaded
    by params.py. Derived values stay computed in code. Gerbers, hole table,
    preview and the PDF drawing are unchanged (one page 2 note reworded).
    make_plate_svg.py now draws both plates from the CSV (plate_layout.svg for
    the alt plate, new pipe_plate_layout.svg with S1/S2 as clones of S0), one
    movable group per part with its holes. read_plate_svg.py reads Inkscape
    moves back into the CSV and checks the rules rows (antenna keep-out, coax
    runs, part and hole gaps, rim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
    [parameters.csv]
2026-11-10 scanner_fw 0.5.0: scanner has no sector
    The scanner doesn't need to know its sector: its D6 goes to its own
    gateway RX pin and the gateway assigns the sector to that pin, so
    wiring decides it. Removes the saved sector claim, the sector console
    and gateway commands, Bucket.sector, the SECTOR_NOT_SET event and the
    SECTOR setting (field numbers reserved in the schema). The value saved
    by 0.4.x is deleted at boot. Flash mode now advertises as
    bletracker-<last 6 hex digits of the chip ID>, and list csv drops its
    sector column.
    Flashed by USB on all three XIAOs. The gateway's sector-claim check
    still has to be removed.
    [decode_frames.py, main.c]
2026-11-11 scanner_fw 0.6.0: ignore list
    Adverts from ignored addresses are dropped in the scan callback, before
    they cost queue space or main-thread time: no RSSI or payload records,
    no console lines, no load. Up to 32 rules, each an address plus a mask
    (prefix /24, a full mask, or * bytes), saved in flash or kept until
    reboot.
    - Console: ignore [list], ignore <addr>[/bits|/mask] [save],
    ignore clear boot|saved|all, ignore off|on, unignore <rule>|all.
    Re-adding a rule with or without save moves it in or out of flash.
    - Gateway commands: Command.ignore / unignore (IgnoreRule) and
    ignore_clear (IgnoreClear), fields 12-14.
    - Every change is a SECURITY SETTING_CHANGED event (Setting 3
    IGNORE_LIST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
    [decode_frames.py, main.c]
2026-11-11 shield_deck: README as a build guide, PCBWay steps split out
    - README starts with a quick start: pick alt or pipe, which template
    pages each build uses, drill sizes and zip-tie counts, then how to
    use the scripts. Fab order steps, settings and hole table move to
    PCBWAY.md (the Gerbers work with any fab).
    - Templates: each page carries a build tag (alt only, pipe only, both)
    with the page set of each build.
    - Plate antenna holes are drawn dotted and labelled "ref" on the pages
    and plate SVGs: reference only, drillable but not by design.
    - plate_layout proposed.svg removed (hand layout, not used by any
    script).
2026-11-11 scanner_fw 0.6.0: ignore list is mast-wide
    Every scanner on a mast ignores the same addresses, so the gateway
    commands ignore / unignore / ignore_clear are only accepted when sent
    to all scanners (like the rssi interval); one addressed to a single
    chip is rejected. The gateway refuses them on <sector>/cmd and sends
    them from all/cmd only. The USB console still works per board, for
    the bench.
2026-11-11 scanner_fw 0.7.0: ignore list readback
    The scanner sends its whole ignore list as a new IgnoreList record
    (Record field 7: each rule's address, mask, saved flag and hits, plus
    paused) in the next bucket after boot, after any change and when asked
    with Command.ignore_list (field 15, to one scanner or all). The record
    goes last in the bucket, outside the byte budget but within 90% of the
    line, so it never trims RSSI or moves the throttle.
    Gateway: publishes each list on retained <sector>/ignore, asks for it
    when it hasn't seen one (after its own restart), and raises
    IGNORE_MISMATCH (SECURITY, WARN) when the online scanners' lists differ
    and IGNORE_MATCH when they agree again. "ignore list" te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
2026-11-11 scanner_fw 0.7.0: event text up to 63 characters
    Command acks such as "ignore list in next bucket (to all)" and
    "ignore clear NOT SAVED" were cut at 39 characters. Buffer size only,
    the wire format is unchanged.
2026-11-11 gateway: scanner fw 0.5.0-0.7.0, firmware check, local ignore list
    - Sector claim check removed (scanner 0.5.0 has no sector; the RX pin is
    the sector): claim fields, retained claim topic, SECTOR_* events and the
    sector command. expected_chip stays; its sensor is now wrong_chip.
    - Firmware check: scanner_firmware (default 0.6.0) is the latest; older
    scanners raise FIRMWARE_OUTDATED + "Sector N firmware outdated".
    Firmware text sensor and retained <sector>/version topic.
    - ignore: the mast's default ignore list, one for all sectors, checked at
    compile time; the gateway drops matching records itself, silently, with
    a per-address DEBUG log every 10 s.
    - Scanner 0.6.0 status/counter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
2026-11-11 scanner_fw 0.7.1: drop and count out-of-range 1 m power
    The advertised 1 m power came straight from unauthenticated advert
    bytes. Eddystone UID/URL subtracted 41 inside an int8_t, so a 0 m power
    below -87 dBm wrapped (-100 came out as +115 dBm), and any iBeacon byte
    was passed on as is (0x7F read as "none").
    The value is now worked out in int and kept only within -100..+20 dBm
    at 1 m. Anything else is left out of the RSSI record (the advert itself
    still counts) and counted in the new Counters.tx_1m_dropped (field 16).
    Gateway: <sector>/counters publishes every Counters field by name,
    including ignored (field 15, missing since 0.6.0) and tx_1m_dropped.
    The self-test's expected counters mess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
    [main.c]
2026-11-11 scanner_fw 0.8.0: debug summary of dropped 1 m power
    A gateway command turns on debug output (off at every boot; one scanner
    or all). With DEBUG_TX_1M on, the scanner sends a TxDrops record (Record
    field 8) in the bucket after each second that had dropped 1 m powers:
    per address (up to 16, the rest counted in omitted) the format (iBeacon,
    Eddystone UID/URL), the byte as advertised, what it works out to at 1 m
    and how many adverts. It uses what RSSI and payloads left of the budget,
    after the throttle has measured the tick, so it never trims RSSI or
    moves the throttle.
    Schema: Command.debug (16, DebugFlag bits, replaces the set, unknown
    bits rejected), Status.debug (20), Record.tx_drops (8),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
    [decode_frames.py, main.c]
2026-11-11 gateway: drop the sector claim check (the RX pin is the sector)
    Scanners stopped sending the sector claim in 0.5.0. The gateway still
    checked it, read the absent field as 0 and flagged the sectors on pins
    1 and 2 suspect, with a SECTOR_MISMATCH every minute.
    Removed: the claim check, SECTOR_MISMATCH, SECTOR_NOT_CONFIGURED, claim
    in the rssi and status JSON, the retained <sector>/claim topic (its old
    value is cleared at connect, like scanner_sector) and the sector
    command. A claim still sent by a scanner before 0.5.0 is skipped.
    Kept: CHIP_CHANGED, and the optional expected_chip check
    (CHIP_MISMATCH, suspect, repeated once a minute). Its all-clear event is
    now CHIP_OK (was SECTOR_OK) and th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
2026-11-11 Check scanner input in the gateway, clean text, strict command parsing
    Gateway (ESPHome):
    - A bucket whose chip ID isn't 8 bytes is dropped as a bad frame
    (a short one used to be zero-padded and accepted).
    - Records with an address that isn't 6 bytes, advert data over 31
    bytes, a known kind that isn't a sub-message, or an unknown kind
    above 63 are dropped and counted in a new bad_records (status JSON,
    logged at most once a minute). Unknown kinds 9-63 still go to
    raw/<n>, so a bad scanner can't make up topics without limit.
    - Scanner version and event text are cleaned before JSON and the log:
    control characters become '?', and non-ASCII too unless valid UTF-8.
    - MQTT commands with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
    [main.c]
2026-11-13 Add openEMS sector model (rf_model/)
    FDTD model of one mast sector built from shield_deck/parameters.csv: copper
    deck, triangular core and whips at the three D holes (monopole or dipole),
    sector 0 fed and the others in 50 ohm. Writes the pattern (deck azimuth
    convention), match, beamwidth, front-to-back and sector isolation. A
    Dockerfile builds openEMS v0.37.0 from source, since Debian 13 has no
    package. First quarter-wave monopole result in rf_model/out/monopole/.
    [pattern.csv]
2026-11-13 Add duck model, bearing simulation and antenna specs (rf_model/)
    - out/dipole/: rubber duck as a sleeve dipole (7.5 dBi at the horizon,
    105-125 deg beam, -51 dB isolation between sectors).
    - bearing_sim.py: bearing and range error from a pattern under BLE noise
    (fading, room reflections, shadowing, averaging window); results in
    out/bearing/ (median 34 deg monopole, 21 deg duck at default noise).
    - spec_sweep.py: idealised beams through the bearing simulation; back
    rejection matters most. Recommended antenna specs in the README.
    - README: corrected the monopole match note (resonates below the band).
    [errors_dipole.csv, errors_monopole.csv, pattern.csv]
2026-11-13 Shield deck templates: formulas page, pipe build first, EMT option
    - Page 7 (new): design formulas worked from parameters.csv: monopole
    (D hole) spacing from the wavelength (RF_FREQ), triangle core and back
    panels, every deck hole radius. Reference only, not to scale.
    - Pipe build listed first: page 2 is now the pipe plate, page 3 the
    no-pipe split plate; build badges and README tables follow.
    - Page 5: 1/2" EMT (steel conduit) as an option instead of the PVC pipe
    (EMT_OD / EMT_ID in parameters.csv).
    - README: check both 100 mm scale bars before drilling.
    Adds RF_FREQ, which rf_model/sector_model.py also reads.
    [parameters.csv]
2026-11-13 rf_model: HiRO H50327 reference antenna, keep and log every run
    - H50327 (2 dBi dipole, 108 mm) modelled with its 2.4 GHz element fed
    55 / 65 / 75 mm below the deck: 7.8-8.0 dBi, 95 deg wide at the
    horizon, median bearing error 19-22 deg (out/h50327_c*,
    out/bearing_h50327).
    - Every run is kept: run_all.sh re-runs them all; each summary.txt
    starts with its command and date; out/runs.csv logs every run
    (runlog.py). Earlier one-off runs now have folders (monopole_coarse,
    dipole_len50). README lists every run.
    - Fix --out with a relative folder (openEMS changes the working
    directory while it runs).
    - Re-running everything reproduced the earlier results within 0.1 dB
    and 1 deg.
    C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
    [errors_dipole.csv, errors_h50327_c55.csv, errors_h50327_c65.csv, errors_h50327_c75.csv, errors_monopole.csv, pattern.csv, runs.csv]
2026-11-13 rf_model: D-hole spacing sweep (--spacing)
    sector_model.py takes --spacing (antenna axis to copper face, default
    DUCK_SPACING). H50327 at 15 / 20 / 25 / 34 mm next to the existing
    31 mm run: closer in gives ~1 dB more gain and 1-2 dB more back
    rejection but only ~1 deg of bearing (19-21 deg median), and shifts the
    feed impedance a long way. Keep the D hole at 31 mm. Runs added to
    run_all.sh, runs.csv and the README.
    [errors_h50327_c65.csv, errors_h50327_c65_s15.csv, errors_h50327_c65_s20.csv, errors_h50327_c65_s25.csv, errors_h50327_c65_s34.csv, pattern.csv, runs.csv]
